dewayne57/Auto_Drain/Auto Drain.kicad_pcb

## KiCad design Auto Drain.kicad_pcb (2026-11-02)

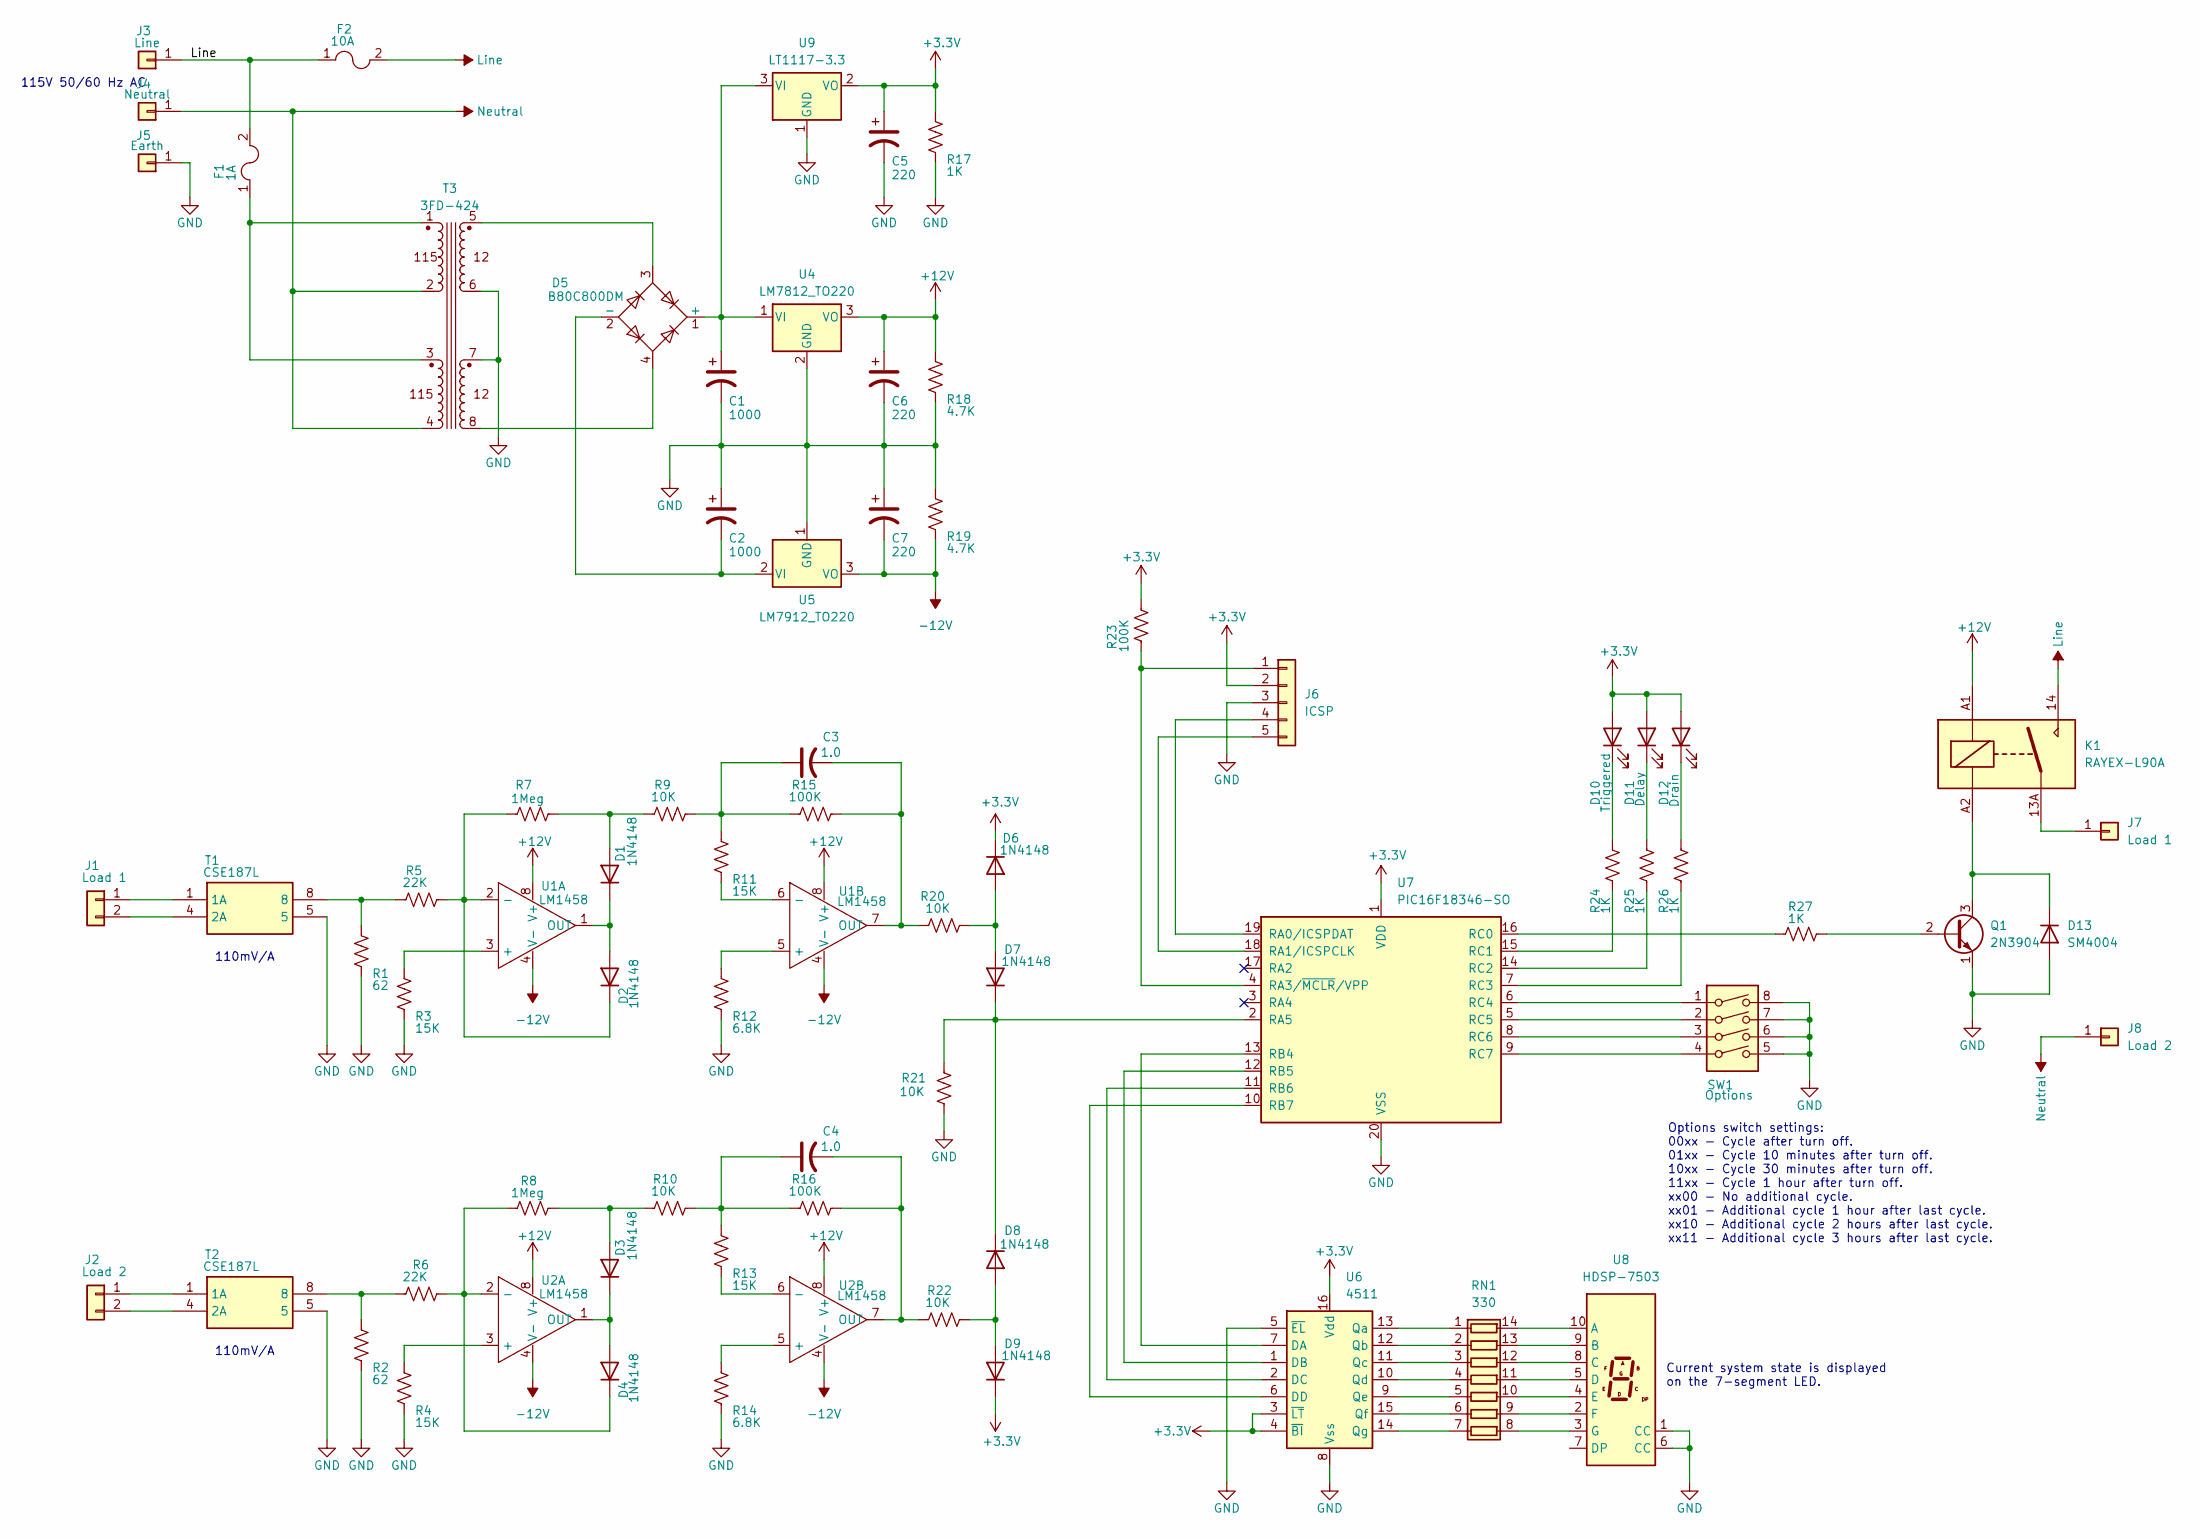
[picture p1: schematic Auto Drain.kicad_sch, Automatic Drain]

Parts:
C1, C2: 1000; CP_Radial_D14.0mm_P7.50mm
C3, C4: 1.0; C_Disc_D10.0mm_W2.5mm_P5.00mm
C5, C6, C7: 220; CP_Radial_D10.0mm_P3.80mm
D1, D2, D3, D4, D6, D7, D8, D9: 1N4148; D_SOD-123
D5: B80C800DM; Diode_Bridge_DIP-4_W7.62mm_P5.08mm
D10: Triggered; LED_D3.0mm
D11: Delay; LED_D3.0mm
D12: Drain; LED_D3.0mm
D13: SM4004; D_MELF
F1: 1A; Fuseholder_Clip-5x20mm_Eaton_1A5601-01_Inline_P20.80x6.76mm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
F2: 10A; Fuseholder_Clip-5x20mm_Eaton_1A5601-01_Inline_P20.80x6.76mm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
J1: Load 1; 389220002
J2: Load 2; 389220002
J3: Line; Amp Faston 250 THT
J4: Neutral; Amp Faston 250 THT
J5: Earth; Amp Faston 250 THT
J6: ICSP; PinSocket_1x05_P2.54mm_Vertical
J7: Load 1; Amp Faston 250 THT
J8: Load 2; Amp Faston 250 THT
K1: RAYEX-L90A; Relay_SPST_RAYEX-L90A
Q1: 2N3904; TO-92_Inline
R1, R2: 62; R_0805_2012Metric_Pad1.20x1.40mm_HandSolder
R3, R4, R11, R13: 15K; R_0805_2012Metric_Pad1.20x1.40mm_HandSolder
R5, R6: 22K; R_0805_2012Metric_Pad1.20x1.40mm_HandSolder
R7, R8: 1Meg; R_0805_2012Metric_Pad1.20x1.40mm_HandSolder
R9, R10, R20, R21, R22: 10K; R_0805_2012Metric_Pad1.20x1.40mm_HandSolder
R12, R14: 6.8K; R_0805_2012Metric_Pad1.20x1.40mm_HandSolder
R15, R16, R23: 100K; R_0805_2012Metric_Pad1.20x1.40mm_HandSolder
R17, R24, R25, R26, R27: 1K; R_0805_2012Metric_Pad1.20x1.40mm_HandSolder
R18, R19: 4.7K; R_0805_2012Metric_Pad1.20x1.40mm_HandSolder
RN1: 330; DIP-14_W7.62mm_LongPads
SW1: Options; DIP-8_W7.62mm_Socket_LongPads
T1, T2: CSE187L; CSE_187L; Mouser Part Number 553-CSE187L
T3: 3FD-424; 3FD-4XX
U1, U2: LM1458; DIP-8_W7.62mm_LongPads
U4: LM7812_TO220; TO-220-3_Vertical
U5: LM7912_TO220; TO-220-3_Vertical
U6: 4511; DIP-14_W7.62mm_LongPads
U7: PIC16F18346-SO; SOIC-20W_7.5x12.8mm_P1.27mm
U8: HDSP-7503; HDSP-A151
U9: LT1117-3.3; TO-92L_Inline

Connections:
+5V: C5.1, D6.1 (K), D9.1 (K), D10.2 (A), D11.2 (A), D12.2 (A), J6.2, R17.1, R23.2, U6.3 (~LT), U6.4 (~BI), U6.16 (Vdd), U7.1 (VDD), U9.2 (VO); also elsewhere on the board
+12V: C6.1, K1.A1, R18.1, U1.8 (V+), U2.8 (V+), U4.3 (VO)
-12V: C7.2, R19.2, U1.4 (V-), U2.4 (V-), U5.3 (VO)
GND: C1.2, C2.1, C5.2, C6.2, C7.1, D13.2 (A), J5.1 (Pin_1_1), J6.3, Q1.1 (E), R1.2, R2.2, R3.2, R4.2, R12.2, R14.2, R17.2, R18.2, R19.1, R21.1, SW1.5, SW1.6, SW1.7, SW1.8, T1.5, T2.5, T3.6, T3.7, U4.2 (GND), U5.1 (GND), U6.5 (~EL), U6.8 (Vss), U7.20 (VSS), U8.1 (CC), U8.6 (CC), U9.1 (GND); also elsewhere on the board
Line: F1.2, F2.1, F2.2, J3.1 (Pin_1_1), K1.14
unnamed: C3.1, R9.2, R11.1, R15.1
unnamed: C4.1, R10.2, R13.1, R16.1
unnamed: D1.2 (A), R7.2, R9.1
unnamed: D1.1 (K), D2.2 (A), U1.1 (OUT)
unnamed: D2.1 (K), R5.2, R7.1, U1.2 (-)
unnamed: D3.2 (A), R8.2, R10.1
unnamed: D3.1 (K), D4.2 (A), U2.1 (OUT)
unnamed: D4.1 (K), R6.2, R8.1, U2.2 (-)
unnamed 13: C1.1, D5.1 (+), U4.1 (VI), U9.3 (VI); also elsewhere on the board
unnamed: C2.2, D5.2 (-), U5.2 (VI)
unnamed: D5.3, T3.5
unnamed: D5.4, T3.8
unnamed: D6.2 (A), D7.2 (A), R20.2
unnamed: D7.1 (K), D8.1 (K), R21.2, U7.2 (RA5)
unnamed: D8.2 (A), D9.2 (A), R22.2
unnamed: D10.1 (K), R24.2
unnamed: D11.1 (K), R25.2
unnamed: D12.1 (K), R26.2
unnamed: D13.1 (K), K1.A2, Q1.3 (C)
unnamed: F1.1, T3.1, T3.3
unnamed: J1.1, T1.1 (1A)
unnamed: J1.2, T1.4 (2A)
unnamed: J2.1, T2.1 (1A)
unnamed: J2.2, T2.4 (2A)
unnamed: J6.1, R23.1, U7.4 (RA3/~MCLR/VPP)
unnamed: J6.4, U7.19 (RA0/ICSPDAT)
unnamed: J6.5, U7.18 (RA1/ICSPCLK)
unnamed: J7.1 (Pin_1_1), K1.13A, K1.13B
unnamed: Q1.2 (B), R27.1
unnamed: R1.1, R5.1, T1.8
unnamed: R2.1, R6.1, T2.8
unnamed: RN1.1 (R1.1), U6.13 (Qa)
unnamed: RN1.14 (R1.2), U8.10 (A)
unnamed: RN1.2 (R2.1), U6.12 (Qb)
unnamed: RN1.13 (R2.2), U8.9 (B)
unnamed: RN1.3 (R3.1), U6.11 (Qc)
unnamed: RN1.12 (R3.2), U8.8 (C)
unnamed: RN1.4 (R4.1), U6.10 (Qd)
unnamed: RN1.11 (R4.2), U8.5 (D)
unnamed: RN1.5 (R5.1), U6.9 (Qe)
unnamed: RN1.10 (R5.2), U8.4 (E)
unnamed: RN1.6 (R6.1), U6.15 (Qf)
unnamed: RN1.9 (R6.2), U8.2 (F)
unnamed: RN1.7 (R7.1), U6.14 (Qg)
unnamed: RN1.8 (R7.2), U8.3 (G)
unnamed: R3.1, U1.3 (+)
unnamed: R12.1, U1.5 (+)
unnamed: R11.2, U1.6 (-)
unnamed: C3.2, R15.2, R20.1, U1.7 (OUT)
unnamed: R4.1, U2.3 (+)
unnamed: R14.1, U2.5 (+)
unnamed: R13.2, U2.6 (-)
unnamed: C4.2, R16.2, R22.1, U2.7 (OUT)
unnamed: U6.7 (DA), U7.13 (RB4)
unnamed: U6.1 (DB), U7.12 (RB5)
unnamed: U6.2 (DC), U7.11 (RB6)
unnamed: U6.6 (DD), U7.10 (RB7)
unnamed: R27.2, U7.16 (RC0)
unnamed: R24.1, U7.15 (RC1)
unnamed: R25.1, U7.14 (RC2)
unnamed: R26.1, U7.7 (RC3)
unnamed: SW1.1, U7.6 (RC4)
unnamed: SW1.2, U7.5 (RC5)
unnamed: SW1.3, U7.8 (RC6)
unnamed: SW1.4, U7.9 (RC7)
Neutral: J4.1 (Pin_1_1), J8.1 (Pin_1_1), T3.2, T3.4

Notes on the sheet:
110mV/A
115V 50/60 Hz AC
Current system state is displayed on the 7-segment LED.
Options switch settings: 00xx - Cycle after turn off. 01xx - Cycle 10 minutes after turn off. 10xx - Cycle 30 minutes after turn off. 11xx - Cycle 1 hour after turn off. xx00 - No additional cycle. xx01 - Additional cycle 1 hour after last cycle. xx10 - Additional cycle 2 hours after last cycle. xx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

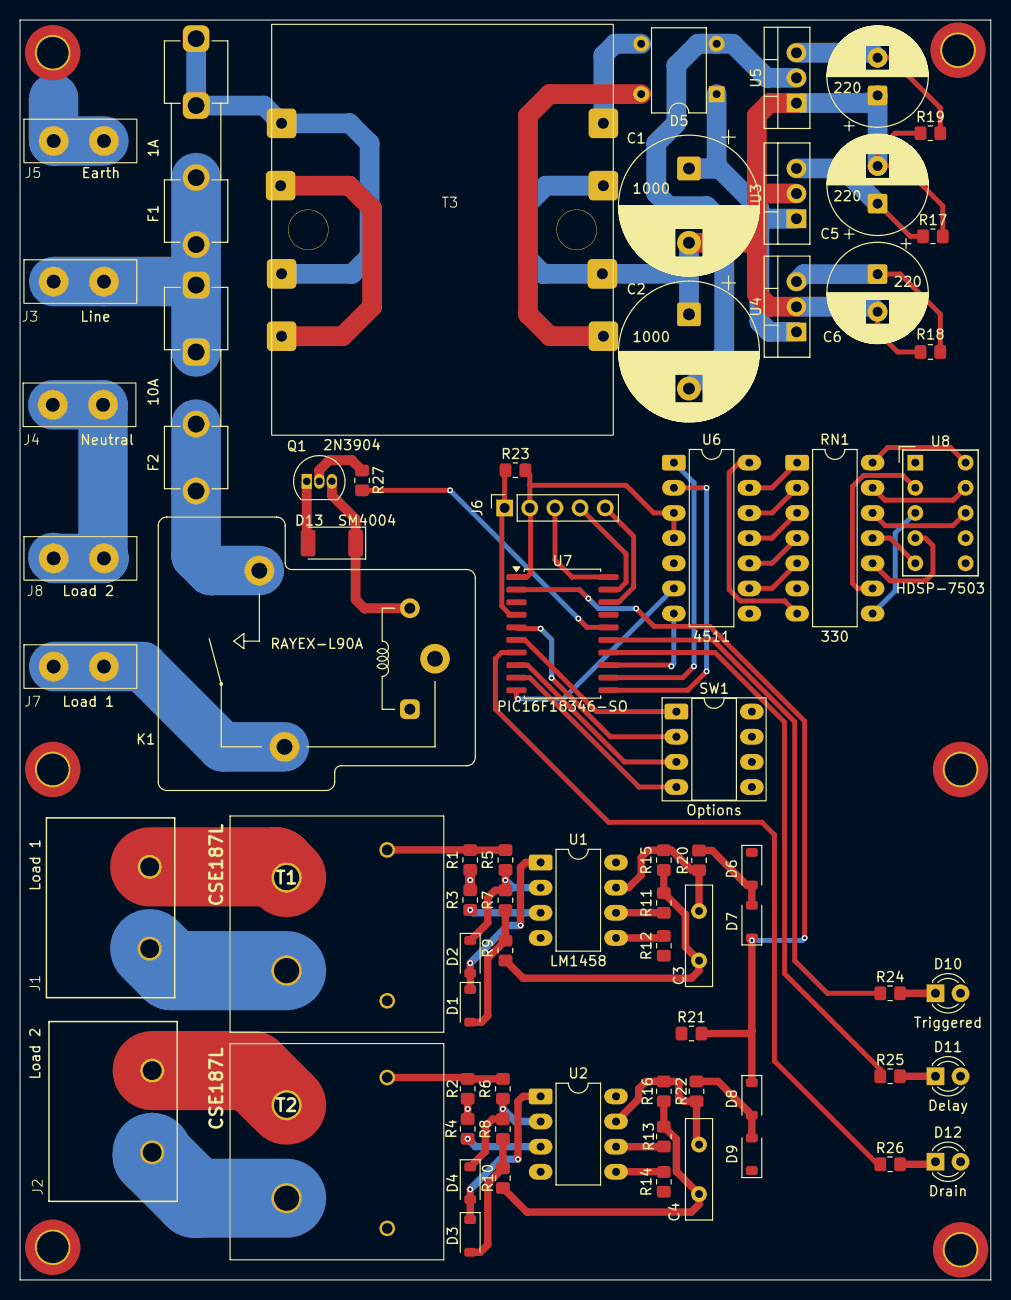
[picture p2: board Auto Drain.kicad_pcb from above]

Board: 2 copper layers, 98.0 x 127.3 mm, 72 parts (0 on the bottom side), 70 nets.

Other parts of the board:
U3: LM7805_TO220; TO-220-3_Vertical

Their connections:
+5V: U3.3 (VO); also elsewhere on the board
GND: U3.2 (GND); also elsewhere on the board
unnamed 13: U3.1 (VI); also elsewhere on the board
