dewayne57/Auto_Drain/(commit log)

2026-10-11 updates to use state machine
    [Auto Drain.kicad_sch]
2026-11-02 schematic updates
    [Auto Drain.kicad_pcb, Auto Drain.kicad_sch]
